mimilei/storment/README.md

# storment
Don't weather your storm alone.

[storment informational video](https://youtu.be/P4hDp8nh_tQ)
