mimilei/storment/(commit log)

2017-05-06 Added arduino and pi files. Modified readme.
2017-05-06 Added laser files for cloud and soundbox.
2017-05-06 Added front door and helmet mount files.
